mihaigabriel620/navhud-claude/docs/img/app-ui.png

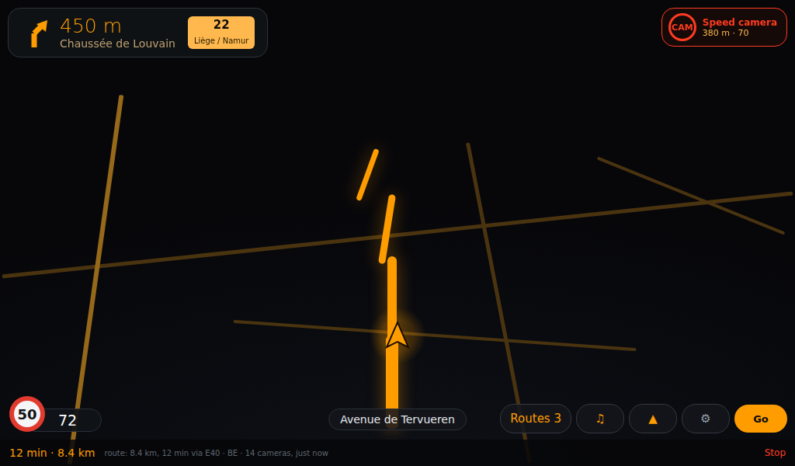
docs/img/app-ui.png
