mihaigabriel620/navhud-claude/docs/img/hud-themes.png

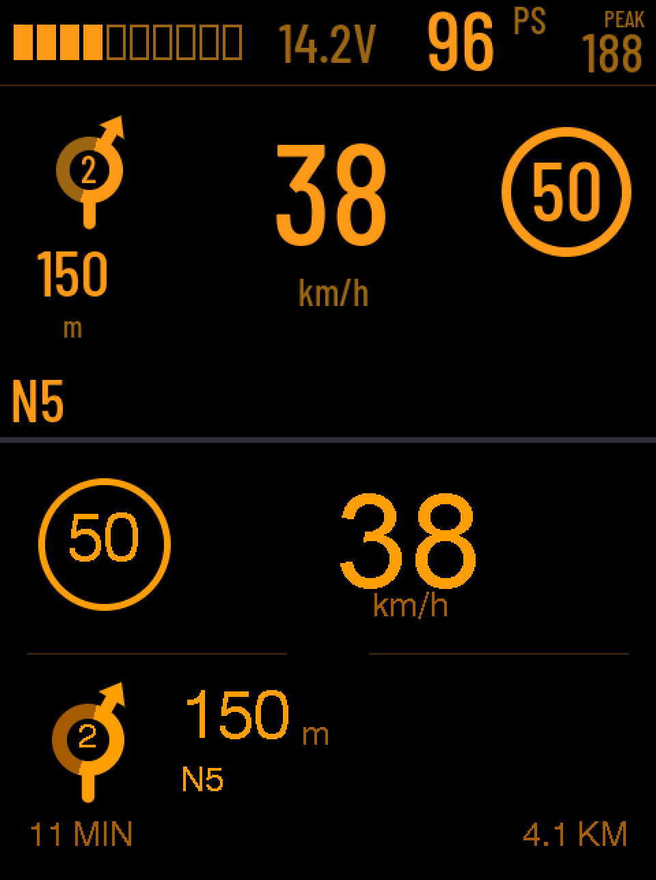
docs/img/hud-themes.png
