mihaigabriel620/navhud-claude/arduino/NavHud/hud_link.h

// ---------------------------------------------------------------------------
//  hud_link.h -- the cable to the phone.
//
//  Everything that crosses the USB serial line, in both directions: the frames
//  the board sends up (hello, compass, car) and the commands it takes back down
//  (geometry, alignment pattern, compass calibration).
//
//  If a message is missing, malformed, or the app and the board disagree about
//  what a field means, it is this file and PROTOCOL.md.
//
//  The wire format itself -- checksums, parsing, the frame grammar -- lives in
//  hud_protocol.h, which is shared with the host tests and knows nothing about
//  Serial.
// ---------------------------------------------------------------------------
#ifndef HUD_LINK_H
#define HUD_LINK_H

/**
 * Say out loud what the panel is doing, on the serial line.
 *
 * Plain text rather than $ sentences on purpose: a human with a serial monitor
 * is the audience, and the phone's parser ignores anything that does not start
 * with a '$' anyway.
 */
static void diag(const char* s) { Serial.print(s); Serial.print("\r\n"); }

static void sendLine(const char* body) {
  char line[80];
  snprintf(line, sizeof line, "$%s*%02X\r\n", body,
           HudParser::checksum(body, strlen(body)));
  Serial.print(line);
}

static void sendHello() {
  // Protocol 3. The board no longer advertises an IMU capability because there
  // is no longer any code that could use one; the app already treats $IMU as
  // optional and simply never sees one.
  sendLine("HELLO,NAVHUD,3");
}

#ifdef HUD_MAG
/**
 * $MAG,<headingDeg>,<calibrating>,<samples>,<fieldUt>,<spreadPct>,<mount>
 *
 * Magnetic north, not true: declination depends on where you are, the phone
 * knows that and this board does not. Absolute, and available standing still,
 * which is the one thing GPS cannot give.
 *
 * Sent only while the compass is genuinely reporting. A line that says 0.0
 * every 200 ms because the chip is absent is worse than silence -- the app
 * cannot tell it from actually pointing north.
 *
 * The field is six wide and stays six wide, because the app reads it
 * positionally. Field 5 was a rolling spread measure from the old driver; it is
 * now 0, because the QMC5883P renews its own offset on every measurement with
 * set-and-reset enabled and the number had stopped meaning anything.
 *
 * FIELD 6 IS LOAD-BEARING AND IT IS EASY TO GET WRONG. The app reads it as
 * "is the number in field 1 a heading for the CAR, or just for the chip", and
 * anything other than 1 makes it ignore the compass completely and fall back
 * to the phone's own sensors. That is the right rule and it is not changing.
 *
 * The rewrite briefly reported compass.calibrated() here, which meant a board
 * that had never been told `spin` sent 0 for ever and the app silently never
 * used the HUD compass at all. Wrong question: hard-iron calibration is about
 * how ACCURATE the heading is, not whether it is a car heading.
 *
 * The next attempt tied it to the measured field magnitude being plausible,
 * and that was wrong too -- wrong in a way worth writing down, because it
 * looked so reasonable. A scale-factor bug made the field read 13.3 uT instead
 * of 49, the plausibility check correctly said "that is not the Earth's field",
 * and field 6 went to 0 -- so the app threw away headings that were PERFECTLY
 * CORRECT. They were correct because the heading is atan2 of two components
 * scaled by the same factor, and atan2 does not care about scale. A magnitude
 * error cannot move the heading by one degree.
 *
 * So field 6 is now exactly what the app asks it: is this a car heading. The
 * chip is answering, so yes. Whether the magnitude looks like the Earth's is a
 * separate question with its own answer in field 4, which the app already
 * checks for its status line -- and which belongs in a warning, never in a
 * silent switch that disables the only absolute heading in the system.
 *
 * Alignment to the car is the `north` offset, which defaults to zero -- "the
 * chip points forwards" -- and one command fixes it.
 */
static void sendMag() {
  char body[72];
  snprintf(body, sizeof body, "MAG,%.1f,%u,%u,%.1f,%u,%u",
           compass.headingDeg,
           (unsigned)(compass.calibrating() ? 1 : 0),
           (unsigned)compass.calCount(),
           compass.fieldUt,
           0u,
           (unsigned)(compass.present() ? 1u : 0u));
  sendLine(body);
}
#endif
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
