mihaigabriel620/navhud-claude/(commit log)

2026-09-19 NavHUD 1.26 - recovered source, all fixes ported
    [AreaRoads.kt]
2026-09-23 Snap the marker to the road by default
    New pref key snap_to_road_v2 defaulting to true, so every install
    (including those that stored the old false default) switches to
    snapping. Getter/setter names unchanged.
2026-09-23 Draw the puck with a LocationIndicatorLayer
    The puck was a SymbolLayer over a GeoJSON source re-set every frame.
    GeoJSON updates are parsed on a worker thread and land a frame or more
    after the moveCamera beside them, so the arrow trailed the map. The
    indicator layer's position and bearing are layer properties, applied in
    the same render as the camera.
    LocationIndicatorLayer is package-private in MapLibre 11.8, so it is
    constructed by reflection (minify is off) and configured through the
    public Paint/LayoutPropertyValue constructors with the style-spec names.
    Location and bearing transitions are zeroed. The dot/arrow bitmaps are
    the bearing image, switched only when the heading becomes (un)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
2026-09-23 Fix map stutter: render at panel rate, no skipped frames, O(log n) pointAlong
    - setMaximumFps(30) made MapRenderer sleep to 33 ms per render while the
    camera moved every 16.7 ms vsync, so the map advanced 2-1-2 frames.
    It now uses the display refresh rate, capped at 60.
    - skipNextFrame removed: Choreographer never queues missed vsyncs, so the
    deliberate skip only doubled every hitch.
    - Geo.pointAlong (and so bearingAlong) binary-searches cum instead of
    scanning from vertex 0; GeoTest checks it against the old scan.
    [Geo.kt, GeoTest.kt]
2026-09-23 Voice: chimes as TTS earcons instead of a ToneGenerator on STREAM_MUSIC
    The ToneGenerator took no audio focus and played on the media stream, so a
    head unit treated each beep as a new media source and paused the music.
    Two short two-note chimes (warn falling, camera rising; 16-bit mono 22050 Hz,
    -6 dBFS, 10 ms fades) are now res/raw earcons registered after TTS init and
    played with playEarcon(QUEUE_ADD), under the same navigation-guidance audio
    attributes and utterance accounting as speech.
    [VoiceGuide.kt]
2026-09-23 Voice: one audio-focus hold per burst, released 300 ms after the last line
    Focus used to be abandoned the instant the utterance counter hit zero, i.e.
    between a chime and its line, and the request result was ignored. Now the
    release is posted to the main looper 300 ms after the queue empties and
    cancelled by the next line; request/abandon/release are serialised under one
    lock (tick thread, main thread and TTS binder thread all touch it). Focus is
    only marked held when AUDIOFOCUS_REQUEST_GRANTED; stopNow() and shutdown()
    release immediately. Legacy (API 24-25) path kept.
2026-09-23 Arrival ends the route
    RouteTracker also arrives when parked within 30 m of the pin with under
    60 m of route left. HudService ends navigation on the arrival frame via
    clearRoute() after the frame has gone to the HUD and the voice, so the
    tracker, route and destination go and reroute cannot send the driver
    back to where they are standing.
2026-09-23 Faster reroute: 30 m off-route, sustained heading shortcut
    OFF_ROUTE_M 45 -> 30. The heading shortcut is now: more than 45 degrees
    from the route bearing and more than 15 m off the line, held for 2 s,
    so it fires before the car is off the line at all. It replaces the
    zero-debounce 60 degree path, which at the new 30 m threshold would let
    a single multipath fix reroute. Only a fix under 2 s old counts as
    evidence, since the tick extrapolates older fixes along their bearing.
    Cooldown, confirm and obvious-distance rules unchanged.
    [HudService.kt, RouteTracker.kt, StutterAndReactionTest.kt]
2026-09-23 Voice: own queue, one item at a time, nothing interrupts anything
    Every urgent line used QUEUE_FLUSH, so turn calls, camera warnings and the
    speed warning cut each other off mid-word. VoiceQueue (voice/, pure, with a
    Speaker seam) now hands the engine one item -- chime + line -- at a time with
    QUEUE_ADD and starts the next on onDone/onError/onStop. Items carry a
    priority (HIGH: turn now, arrival, speed, camera; NORMAL: prepare; LOW:
    road features, closures, recalcul) and an expiry; LOW is dropped when
    anything is playing or waiting; a newer call for the same maneuver replaces
    a waiting one; a line whose end never arrives is written off after 20 s.
    QUEUE_FLUSH is left only to sample() and sto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
    [VoiceGuide.kt]
2026-09-24 Move the marker with a bounded rubber band instead of exponential easing
    New map/PuckMotion.kt (pure, unit-tested in PuckMotionTest):
    - PuckMotion: 1-D along-line motion. Target = fix along + v * fix age;
    drawn speed = v + bounded correction, changing at most 4 m/s^2; never
    moves backwards (slows to wait); jumps only past 300 m. Fix lost: runs
    on the reference speed (car speed, else last GPS speed) up to the coast
    limit, then holds. Fix back: converges without a snap.
    - FreeDriveMotion: the same band along the direction of travel (the
    matched road's bearing when known, so coasting follows a bend), with a
    bounded sideways correction and snapWithin applied last.
    MapActivity: the o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
2026-09-24 Voice: fold close turns into one call; onReroute() that does not repeat
    onFrame gains optional thenManeuver/thenGapM. When the "now" call is spoken
    and the next maneuver follows within max(150 m, 8 s at current speed), it
    becomes "Tournez à droite, puis tournez à gauche." (Phrases.immediateThen /
    brief, EN + FR) and the folded maneuver's prepare stage is marked spoken;
    its own "now" call still comes. Straight-on is never folded.
    onReroute() (thread-safe flag, applied on the next frame) clears the old
    route's keys but carries the last turn's stage across when the new route's
    first maneuver has the same instruction and is no further away than when it
    was announced; a turn already inside its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
2026-09-24 Heading: GPS course only while moving, rate-limited turns
    - HeadingFusion.moving: over 5 km/h, back under 3.5 km/h (the compass
    crossover constants), from the car's speed when the bus reports one
    (MapActivity now passes it to onFix too). While moving, onGyro,
    onOrientation and onExternalYawRate no longer change the heading, so
    it is the smoothed GPS course. Standstill/crawl behaviour unchanged.
    - Arrow and map share one heading while moving (Marker.headingFor gets
    a moving flag): the road bearing when snapped, else the GPS course.
    - NavCamera.turnToward: exponential easing capped at MAX_TURN_DPS
    (180 deg/s), used by the map bearing and the arrow. Replaces the
    instant >90 deg ju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
    [CameraAndMapTest.kt, HeadingFusion.kt, StutterAndReactionTest.kt]
2026-09-24 Speeding: SpeedingRule -- sustained, banded, once per excess
    The over-limit chime fired at limit+5 the instant the GPS speed crossed it,
    re-armed the instant it dipped back, repeated every 9 s up to 4 times, and
    treated an unknown limit as a re-arm. SpeedingRule (pure) now warns when the
    speed stays above limit + margin (10 up to 50, 20 up to 90, 30 above) for
    3 s, then holds a 3 min cooldown, re-armed early by 5 s at or below limit-10
    or by a change of the known limit. An unknown limit (0/-1) or no fix neither
    triggers nor re-arms and clears the sustain timer. VoiceGuide queues one
    HIGH item per trigger: warn earcon + "Vitesse limitée à X"; no bare beeps.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
    [VoiceGuide.kt]
2026-09-24 Waze-style vanishing route line, cut exactly under the arrow
    The route used to be one thinned source with a grey travelled overlay
    redrawn from the 4 Hz alongM on the 200 ms tick, so on bends the arrow
    (projected on the full geometry) sat off the drawn line and the cut
    lagged the car.
    New map/RouteLine.kt (pure, RouteLineTest): trafficLevels (the existing
    run-absorption logic, moved) and routeSlice(route, fromM, toM, levels,
    stride), which returns level runs starting at an interpolated point and
    sharing boundary vertices.
    MapActivity draws two sources: NEAR = arrow along -> far start at full
    resolution, rebuilt from the frame loop at most ~15 Hz from puckAlong
    (HudService.alongM when not s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
2026-09-24 Follow mode: only a one-finger pan unfollows; pinch and tilt are kept
    - Removed the touch listener and the REASON_API_GESTURE listener that
    dropped follow mode on any touch, pinch or tilt.
    - OnMoveListener: onMoveBegin with one pointer -> following = false.
    - OnShoveListener / OnScaleListener: while active the frame loop skips
    moveCamera; on end the tilt (clamped TILT_MIN..TILT_MAX) and a zoom
    offset on the speed-based zoom are stored in NavCamera and kept while
    following. NavCamera.reset (recenter / refollow) clears them.
    - Rotate gestures are disabled while following.
    [CameraAndMapTest.kt]
2026-09-24 Cameras: per-country rules for a drive across Europe, sourced
    CountryRules now covers the countries on a Belgium-Romania drive and its
    neighbours, each with its source (ADAC per-country table, Moniteur
    Automobile 2026, TomTom's legal page, VIAS 2023-R-16):
    EXACT BE NL LU AT HU RO HR IT ES PL; ZONE FR; OFF DE CH LI CY MK TR.
    Czechia, Slovakia, Slovenia (conflicting/unclear sources) and anything
    unchecked keep the cautious ZONE default.
    normalise() reads what lookups actually return -- ISO-2 in any case, OSM
    region codes (BE-VLG, DE:urban; Area.regionCode works offline), alpha-3,
    and country names in EN/FR/native -- so Mapbox's name fallback
    ("Allemagne") no longer drops Germany to danger-zon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
    [CameraAndMapTest.kt]
2026-09-24 Cameras: ANPR, 35 m corridor, rebase on reroute, offline cache
    - ANPR: the route query also asks for man_made=surveillance +
    surveillance:type=ALPR (OSM wiki; ANPR accepted, case-insensitive).
    New SpeedCamera.Kind.ANPR (appended, ordinals unchanged) for a plain
    plate camera; one that enforces a speed stays FIXED and a section-control
    device stays AVERAGE. Phrases.anprAhead: "Caméra ANPR dans ..." /
    "Number-plate camera in ...".
    - Corridor 15 m -> 35 m: route polylines sit 5-12 m off the carriageway and
    15 m dropped cameras on our own road; the parallel street is rejected by
    onOurRoad (CameraRoadTest's tolerance test updated to the new rule).
    - CameraWatcher.rebase(route) re-pi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
    [SpeedCameras.kt, VoiceGuide.kt]
2026-09-24 Keep the next 80 km of the route downloaded, in rolling chunks
    Offline tiles for the route ahead, without caching a 2000 km trip whole:
    - map/OfflineCorridor.kt (pure, OfflineCorridorTest): a chunk is the
    next 80 km of route from 1 km behind the car; a new one is due once
    the car is halfway through the current one (about 50 chunks for
    Belgium -> Romania). Its geometry is the route slice plus a line 1 km
    either side, thinned to <= 2000 points in total.
    - map/OfflineRoutes.kt: one MapLibre OfflineGeometryRegionDefinition
    per chunk (MultiLineString, z10-14, no ideographs), download set
    active and stopped when complete. Before each create it lists regions
    and deletes all of ours (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
2026-09-24 Waze-like reroute: forward bearings, loop-back penalty
    Directions requests send bearings=<h>,45 whenever the car is moving
    (car speed when fresh, else GPS > 2 m/s); alternatives stay on. The
    service keeps a 300 m GPS breadcrumb and the last on-route snapped
    position; on a reroute RouteChoice adds 180 s to any candidate that,
    within its first 3 km, comes back past the departure point or runs
    back along the breadcrumb for more than 100 m, so the fastest forward
    route wins. The existing U-turn tolerance rule is unchanged.
    [HudService.kt, MapboxProvider.kt]
2026-09-24 Speed limits on routes, and Europe-wide legal defaults
    RouteTracker takes an injectable limitFallback used where the router's
    maxspeed is unknown; HudService wires it to SpeedDefaults.limitAt (OSM
    window match, then legal default), the same derivation FreeTracker now
    reaches through SpeedDefaults.limitOf. The 400 m hold no longer carries
    a limit past a maneuver.
    SpeedDefaults gets one per-country table (BE-VLG/WAL/BRU, BE, NL, LU,
    FR, DE, AT, CH, CZ, SK, HU, RO, PL, IT, ES; checked against the OSM
    wiki legal-default table and implicit-value list and the cited national
    codes): urban, rural, expressway/trunk, 2x2 dual, motorway, urban
    motorway, living street. Bare BE urban is 50. AreaRoads' i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
    [AreaRoads.kt, DerivedLimitTest.kt, HudService.kt, RouteTracker.kt, SpeedDefaults.kt, SpeedDefaultsTest.kt]
2026-09-24 One speed for app and HUD
    HudService.displaySpeedMps is the raw (unscaled) bus speed when fresh
    and plausible, else GPS; it feeds HudFrame.speedKph on routes and in
    free drive, so the app gauge, the voice over-limit chime and the HUD
    agree. The scaled bestSpeedMps still places the car. CarLink latches a
    bus zero as implausible after 3 s with GPS above 15 km/h, until the
    bus reports motion again (the firmware sends 0 for a stale frame).
    carSpeedMps and carStopped are refreshed every tick, so they go null
    within a tick of the data going stale.
2026-09-24 Tunnel coasting in the service; thenManeuver accessor
    RouteTracker.coast() runs the position on along the route when the fix
    is gone (after the service's 8 s lead), at bestSpeedMps: the countdown,
    limits, maneuvers and snap carry on, the frame drops GPS_OK so the HUD
    says NO GPS. After RouteTracker.COAST_MAX_MS (180 s), or if the car was
    not on the route, it is exactly the old no-fix frame.
    HudService.alongM/alongAtMs are now the along-route distance of the
    last real fix (RouteTracker.alongOf, non-mutating) and that fix's
    elapsedRealtime, published once per fix and never advanced by the lead
    or by coasting. snapTrusted stays true while coasting.
    RouteTracker.thenManeuver: the maneuver afte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
    [HudService.kt, NavLogicTest.kt, RouteTracker.kt, SnapTest.kt]
2026-09-24 Rolling offline road cache along the route; fair use; cache labelling
    On a route the Overpass window follows the route: 2 km circles centred
    on the line every 2 km (AreaRoads.routeWindow). HudService prefetches
    them in rolling chunks -- ~100 km ahead, topped up when under 50 km is
    left, one request at a time on aux at least 3 s apart, skipping windows
    already fresh, restarting on a new route or reroute, backing off 30 s
    to 10 min on failure -- and the live lookup asks for the same window,
    so it is a disk hit and works with no signal. AreaCache also caps the
    total size (120 MB) so a long trip keeps only what is ahead.
    AreaCache names files by the exact circle they cover and returns it:
    a loo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
    [AreaRoads.kt, HudService.kt]
2026-09-24 Network failures stay quiet; route country from Mapbox admins
    Every Mapbox failure (no network, timeout, error page, non-JSON body,
    no route) now comes out as NavException, through an injectable GET used
    by the new failure-path tests. While a failed route request is retrying
    on its back-off (RerouteRule.retryDelayMs: 2, 4, 8, 16, then 20 s, for
    ever), maybeReroute starts no new requests, so a dead network is not
    hammered every 6 s cooldown and recalculating is not repeated; the
    old route keeps guiding meanwhile. setStatus cannot throw into a
    network thread's catch block.
    countryAt returns the ISO code or null, never the country's name.
    parseRoute reads each leg's admins and every intersecti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
    [HudService.kt, MapboxProvider.kt]
2026-09-24 Wire voice and camera work into the service; keep camera cache out of area lookups
    - voice.onFrame gets the maneuver after the next one ("... puis a gauche")
    - a replacing route calls voice.onReroute(), a fresh one voice.reset()
    - cameras are re-projected onto a new route at once (watcher.rebase), and
    successor() keeps the announced set across refreshes and country changes
    - cameraGen guards the camera fetch against reroutes, which keep routeGen
    - camera lists are cached on disk (SpeedCameras.fetch(r, AreaCache))
    - country: normalised lookup, OSM region code as the offline fallback, and
    the route's own per-segment country wins while a route runs
    - AreaCache.putNamed/getNamed: the camera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
    [HudService.kt, SpeedCameras.kt]
2026-09-24 Tunnels: ignore network fixes while the route is snapped on GPS
    Past FixFilter's 10 s grace a cell fix got through, refreshed the fix age,
    ended coasting and put the car up to 200 m off the line, so it rerouted
    from the surface. Ignored while the snap is trusted; used again once
    coasting gives up.
    [HudService.kt]
2026-09-24 Tunnels: a minute on a held GPS speed; a coast never arrives or says now
    Without the car bus the service and the map coast at the last GPS speed,
    held constant, for 60 s (180 s at bus speed, as before). A coasted frame
    no longer carries the arrival flag, so a tunnel or car park cannot end the
    route, and without the bus it cannot fire a turn's final "now" call; that
    waits for the first real fix. The map takes its coast speed from the
    service's fix, which in a tunnel is still the last GPS one.
    [HudService.kt, RouteTracker.kt, SnapTest.kt, VoiceGuide.kt]
2026-09-24 Reroute: adopt on the tick thread, with the new route's alongM first
    adoptRoute ran on the network thread, so a tick still on the old route
    could overwrite the new route's alongM and spend the voice's reroute
    memory on an old frame. It is now posted to the worker, as a picked
    alternative already was, and releases `rerouting` there. It publishes
    the new route's distance for the last fix before the route itself and
    clears snapTrusted until the new tracker's first tick, so the map no
    longer places the arrow at the old route's metres on the new line.
    [HudService.kt, SnapTest.kt]
2026-09-24 Cameras: lock the announced set that successor() copies across threads
    The tick adds to it while successor() iterates it from the camera fetch,
    the country lookup or the settings screen; a ConcurrentModificationException
    on the aux executor is uncaught and kills the app.
2026-09-24 Area cache: write files whole; drop and refetch one that is unreadable
    A power cut mid-write left half a JSON body under the real name, and the
    fresh-hit path parsed it before ever trying the network, so that window
    failed for a week. Files are now written aside and renamed into place,
    and a cached window that will not parse is deleted and fetched again.
    [AreaRoads.kt]
2026-09-24 Map: judge "stopped" on the car's speed, as "moving" already is
    Parked with the bus reading zero, GPS wander of 1-2 m/s made the map
    think the car was rolling, so a snapped road bearing overrode the
    heading the car was actually facing.
2026-09-24 Icons from the supplied pack: road-ahead chip signs, ANPR map pin
    The road-ahead chip now carries the sign for a level crossing (pack
    rm_railroad, its pale ground shadow darkened for the dark map) or a
    speed bump (pack permanent_hazard_speed_bumps, recoloured from yellow
    to the app amber with dark-on-amber ink). Toll booths and closures keep
    text only: the pack has no matching sign.
    ANPR cameras get their own map pin: the camera bitmap in amber, raised
    over a number plate, chosen per feature by a "kind" property.
2026-09-24 Camera panel: label ANPR cameras as such
2026-09-24 CI: setup-java v5 (v4 deprecated), pin ubuntu-24.04 before the 26.04 switch
2026-09-24 Voice: 3 calls for motorway exits, camera calls quote the stage distance, music focus fixes
    - Exits, slip roads and forks get 1200/500/200 m calls at >=90 km/h (scaled
    down with speed); ordinary turns keep their 2 calls.
    - Speed cameras: 1000/500/200 m at >=90 km/h, 600/300/150 at >=50. The voice
    quotes the stage's round distance, never the live one (the 'in 13 m' call),
    and says just 'Radar' under 50 m. The HUD still shows the live distance.
    - TTS is marked ready only after its navigation audio attributes are set, so
    no line can go out as plain media (which stops music on a head unit).
    - Audio focus watchdog: a line whose end never comes back no longer keeps
    the music ducked/pause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
    [CameraAndMapTest.kt, SpeedCameras.kt, VoiceGuide.kt, VoiceGuideTest.kt]
2026-09-24 Arrow: on the route line up to 50 m, else on the nearest OSM road, raw fix last
    With a route, the arrow fell back to the raw GPS fix (beside the road) as soon
    as the route snap lost trust at 25 m cross-track, or while off route before
    the reroute arrived. Now the map draws it on the route line while within 50 m
    and not off route; otherwise on the nearest OSM road (AreaRoads.match, 35 m);
    the raw fix only when no road is near (car park, driveway).
    Settings > diagnostics: 'Show arrow debug line' puts ROUTE/ROAD/RAW,
    cross-track, trust and GPS accuracy on the map for the next test drive.
    Claude-Session: https://claude.ai/code/session_01P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
    [HudService.kt, MainActivity.kt, RouteTracker.kt, SnapTest.kt]
2026-09-24 Setup: show offline cache status (roads/cameras on disk, map tile chunk ahead)
    Claude-Session: https://claude.ai/code/session_01PBqYeSK4cVS6JAR2wXgoxy
2026-09-24 Cameras: next camera ahead takes over at once; merge duplicates within 50 m
    The last warning at 13 m was late, not only worded wrong: the watcher kept
    the alert on a camera until 40 m past it, so a camera just after it (often
    the same device mapped twice in OSM) got its last call almost on top of it.
    - CameraWatcher picks the first camera ahead; the one just passed is only a
    display fallback and is never announced.
    - Same-kind cameras facing the same way within 50 m (along the route, or
    straight-line in free drive) are merged; limit/kind kept from either.
    - Debug line on the map shows the camera alert.
    Tests: two cameras 30 m apart warn once (1000/500/200), non-duplicates kept,
    next came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
    [AreaRoads.kt, CameraAndMapTest.kt, SpeedCameras.kt]
2026-09-24 App 1.29: arrow locked to its road, "Waiting for GPS", pill flush left
    - map/RoadLock: the map picks the nearest road within 150 m and keeps it;
    fixes move the arrow only along it, standing still holds it, road changes
    only while driving (clearly nearer road on 2 fixes, off the end of the way
    at a junction, or >100 m away). Used in free drive and off the route line.
    1.28 relied on the service's per-fix 35 m match and fell back to the raw fix.
    - No arrow before the first fresh GPS fix or after GPS loss once coasting
    ends; a centred "Waiting for GPS" instead. Cell fixes neither draw nor lock.
    - Arrow debug line: LOCK <road> [held] / RAW <why> / WAIT, provider.
    - Trip pill flush again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
    [AreaRoads.kt, HudService.kt]
2026-09-24 App 1.29.1: search box back in place; only the search button moves into its rounded end
2026-09-24 Location: ask FINE+COARSE together; say "Precise location needed" on approximate
    Android 12+ may ignore FINE requested alone, and the driver can pick
    "Approximate". Navigation still requires FINE, but the map screen now shows
    a notice with a tap-through to the app settings instead of doing nothing,
    and Setup lists Location with an "Open app settings" button. Notice gained
    an optional action line.
2026-09-24 Start with the car: ask for "Allow all the time"; don't start blind at boot
    ACCESS_BACKGROUND_LOCATION was declared but never requested, so on
    Android 11+ the boot-started service got no location (14+: it could not
    go foreground and stopped). Setup now explains and asks for it on its own
    (API 29+) when start-on-boot is on; BootReceiver stays down on 11+ without
    it, and Setup shows a "Start with the car" line with the settings button.
2026-09-24 HUD: blank camera bar and lane strip when a new destination replaces the route
    The new-destination branch nulled cameraAlert and lanes without sending the
    clearing frames clearRoute sends, so the HUD kept the old camera warning and
    lane arrows. A flag now makes the tick send CAM,0,0,0 and LANE,0,0 once the
    link is open, and resets lastLanesSent there.
    [HudService.kt]
2026-09-24 CLAUDE.md: owner currently prefers PC sessions
2026-09-24 USB: stop re-asking after a refusal; make "open when granted" work
    Any answer to the USB permission dialog reset the ask throttle, so a
    refusal brought the dialog back every ~3 s over the map. Now only a grant
    (checked with hasPermission; the immutable PendingIntent carries no extra)
    opens at once; a refusal is remembered for that device id until it is
    replugged or a new link is built. The opener executor was shut by every
    open (closeLocked), so the grant path never ran: it is now retired only by
    the public close(), and a write failure closes internally.
2026-09-24 Location switch off: say "Turn on Location" instead of blaming the permission
    On Android 14+ a location foreground service also needs the Location
    switch on; the service stopped with "location permission is required".
    It now says "turn on Location" when that is the cause, and the map screen
    shows a notice with a tap-through to the location settings.
2026-09-24 Setup: warn when notifications are off, with a button to allow them
    On Android 13+ a refused notification permission hides the service's
    notification, and with it the only Stop action and the "Resume route?"
    offer. Setup now lists Notifications and offers the app's notification
    settings.
2026-09-24 Map: a recreation after Stop no longer restarts the service
    firstResume was per instance, so the dusk night-mode recreation counted as
    opening the app and switched the stopped service back on. It is now true
    only when there is no saved state.
2026-09-24 Setup: Bluetooth switch and Mapbox token apply to the running service
    Both only wrote prefs, so they took effect on the next start. The token now
    goes through HudService.applyPrefs (which rebuilds the router), and the
    Bluetooth switch sends ACTION_START with the new setting when the service
    is running.
2026-09-24 Setup: list the offline-roads cache off the main thread, every 5 s
    AreaCache.fileCount()/sizeBytes() list a directory of many files and ran
    on the main thread with every 400 ms poll. They now run on a worker thread
    at most every 5 s; the poll shows the last result.
2026-09-24 Voice: rebuild the guide on the next start when TTS failed to initialise
    A TTS init failure was only logged and the voice stayed silent for the
    whole session. VoiceGuide now records initFailed (distinct from "still
    starting"), and HudService.onStartCommand replaces such a guide.
    [HudService.kt, VoiceGuide.kt]
2026-09-25 Cameras: a danger zone is announced once and outlasts the camera
    In ZONE mode the stage still came from the real distance, so "zone de
    danger" was spoken again at 500/200 m (or 300/150 m) before the camera,
    and the alert ended at the camera (route: 40 m after; free drive: at it).
    Both mark the camera's position, which art. R413-15 forbids. Zone mode
    now uses stage 0 only, and the passed camera holds the zone for half the
    zone length (zoneTailM), silently.
2026-09-25 Speed: show the car's own speed when there is no live GPS fix
    Free drive without a fix, a route before its first fix and a tunnel past
    the coast limit all built a frame with speedKph = -1, so the gauge showed
    "--" while the bus speed was fresh. Owner rule: the car's speed whenever
    CAN speed is valid, else GPS. The no-fix frames now take the raw bus
    speed (busKph), -1 only when the bus has none.
    [HudService.kt, RegressionCheckTest.kt, RouteTracker.kt]
2026-09-25 Cameras: no route-camera alerts while off the route
    Off route (and while an offline reroute keeps retrying) the watcher was
    still fed t.alongM, our projection onto the road we left, so the old
    route's cameras could be announced. pushCameras now clears the alert
    while the tracker says off-route, as it does with no watcher.
2026-09-25 Map: without the car's speed, a held arrow stays held until the fix moves
    With no CAN speed RoadLock held the arrow only while the GPS speed was
    under 0.7 m/s, but a parked receiver reports 1-2 m/s of multipath
    wander, so indoors the arrow still crept along the road. On GPS speed
    alone a hold now ends only once the projected fix is more than
    max(accuracy, 10 m) from the held point; with the bus the speed rule
    stays.
    [RegressionCheckTest.kt]
2026-09-25 Voice: forks and slip roads in town get two calls, not three
    Below 50 km/h forks, ramps and keep-left/right used SLOW_EXIT
    (300/120/50 m), three calls on turns that come close together; the owner
    said the app talks too much there. They now use the normal town band;
    the 50-89 km/h and motorway (1200/500/200 m) exit bands are unchanged.
    SLOW_EXIT is gone with its only use.
    [RegressionCheckTest.kt, VoiceGuide.kt, VoiceGuideTest.kt]
2026-09-25 Reroute: no loop while parked off the road before joining the route
    A route starts on the street, so a car in a car park 80 m away (or
    parked 30+ m off the road when a reroute was made) was off route at
    once and rerouted every ~6 s while standing. RouteTracker now keeps the
    first cross-track distance and a `joined` flag (first time within
    30 m); until joined only moving 30 m further away counts as off the
    line, and the heading shortcut in maybeReroute waits for joined too.
    [HudService.kt, RegressionCheckTest.kt, RouteTracker.kt, StutterAndReactionTest.kt]
2026-09-25 Roundabout: take the exit angle from the banner's degrees
    The arrow came from bearing_after - bearing_before of the roundabout
    step, which Mapbox/OSRM put at the roundabout ENTRY, so it showed the
    veer into the circle rather than the exit. The banner primary's
    `degrees` ("the degrees at which you will be exiting a roundabout,
    assuming 180 indicates going straight through") is now preferred:
    turn = 180 - degrees, mirrored for driving_side=left (banner, else
    step). The bearings remain the fallback; exit pairing ($RAB) is
    unchanged. Needs confirming on the road.
2026-09-25 HUD: a reroute clears the old route's lane arrows on the board
    adoptRoute forgot lastLanesSent without sending LANE,0,0, so pushLanes
    then saw "none wanted, none sent" and sent nothing: the missed exit's
    lanes stayed on the HUD. The clear is now sent first (adoptRoute runs
    on the tick thread).
    [HudService.kt]
2026-09-25 Cameras: refetch as soon as alerts are allowed again after an OFF country
    A reroute where camera alerts are OFF (Germany) emptied the camera list
    but left lastCameraFetchMs at the last real fetch, so after the border
    maybeRefreshCameras waited up to 30 min: no Belgian/Austrian cameras
    for tens of km. The OFF branch now resets it to 0.
    [HudService.kt]
2026-09-25 Map: the road lock's first pick is bounded by the fix's accuracy
    RoadLock picked any road within 150 m, so an accurate GPS fix in a car
    park snapped the arrow to the street 80 m away while the service said
    "no road". With a known accuracy the pick radius is now
    min(150, max(35, 2 x accuracy)); an indoor +-60 m fix still locks.
    [RegressionCheckTest.kt]
2026-09-25 Country: a service start keeps the detected country
    Every ACTION_START (the map screen sends one whenever it comes to the
    front) reset the country to home without resetting the 25 km recheck,
    so free drive abroad kept Belgian camera rules - positions shown in
    Germany - for up to 25 km. Home is now only the default before a
    lookup has answered.
    [HudService.kt]
2026-09-25 Heading: restore the parked heading on the first GPS fix, not any fix
    The one restore attempt ran on the first accepted fix, which can be a
    network fix hundreds of metres wide: it missed the 15 m match and the
    parked heading was never restored. The attempt now waits for a GPS fix.
    [HudService.kt]
2026-09-25 Firmware tests: render every HUD screen to PNG (make render)
    tft_stub.h built with -DHUD_RENDER rasterises each call into a 480x320
    RGB565 framebuffer using TFT_eSPI 2.5.43's own algorithms (tft_raster.h):
    circles, triangles (int32 truncation), padding, smooth .vlw fonts and the
    library's built-in fonts, fetched pinned into .tft_espi. render_screens.cpp
    draws splashes, NO LINK, the alignment pattern, the shared layout corpus
    (now corpus.h) plus camera/roundabout/car-only extras for both themes into
    out/<theme>_<nn>_<name>.png, via a dependency-free PNG writer.
    Stub fixes found on the way: MR_DATUM text boxes were recorded as TL, and
    a 20-char corpus street was left without its NUL.
    Co-Auth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
    [corpus.h, png_write.h, render_screens.cpp, test_layout.cpp, tft_raster.h, tft_stub.h]
2026-09-25 Firmware tests: make check green again, and a firmware CI workflow
    The CAN and sketch suites had not compiled since the 2.x rewrite: they
    wanted Arduino.h, the hand-written MCP2515 driver, hud_mount.h and
    hud_imu.h, none of which exist any more.
    - test/Arduino.h and test/mcp_can.h: host stand-ins. mcp_can.h follows
    mcp_can 1.5.1's own receive path (READ STATUS, register reads, DLC & 0x0F,
    id flags in bits 31/30) and counts the DLC>8 overrun the real library has.
    - SPI.h: the MCP2515 simulator gains READ STATUS, register-window receive
    buffers (where mcp_can reads them), RXnOVR on a full buffer, 29-bit ids,
    RTR frames and a stuck-MISO mode.
    - test_can.cpp rewritten for canBegin()/can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
    [Arduino.h, SPI.h, Wire.h, mcp_can.h, test_can.cpp, test_sketch.cpp, tft_stub.h]
2026-09-25 Firmware: $RAB was parsed and then thrown away
    linkPump() had no branch for HUD_RAB, so the bearing only reached the
    parser's scratch copy, and the `tmp = cur` resync after every frame
    discarded it. Every roundabout was drawn from the exit-number table, as if
    the phone had never sent an angle. It is now copied into `cur` like $CAM
    and $LANE, and marks the screen for a repaint.
    Test (sketch_*, group 18b) fails without the fix: the angle stayed at
    HUD_RB_ANGLE_NONE.
    Claude-Session: https://claude.ai/code/session_01E3HoeeUR4dV9iZLd4Eqfe2
    [hud_link.h, test_sketch.cpp]
2026-09-25 Dash theme: the PS number no longer erases the battery's "V"
    The PS field's padding was 106 px, sized for "-888", so its background
    fill ran from x 257 while the battery reading "14.2V" ends at 276: every
    PS change (the 0x0A8 frame rate) wiped the "V". The padding now stops at
    the battery field's own box (DASH_VOLT_X + 74), which still covers every
    three-character value ("500" is 80 px, "-99" 70). Below -99 PS -- about
    three times this engine's overrun braking -- the field shows -99 instead
    of four characters over the battery.
    New pixel checks in the renderer (make render, run by CI): a field drawn
    alone must keep every lit pixel on the full screen. The battery check
    failed for every PS val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
    [render_screens.cpp, theme_dash.h]
2026-09-25 E60 theme: the km/h label no longer cuts off the bottom of the speed
    Font 4's 26 px cell for "km/h" (bottom-centre at y 130) starts at y 104,
    four rows above the bottom of the font 8 digits, and its background fill
    clipped them on every speed. The label is now drawn without a background:
    e60DrawSpeed clears the whole block first, so nothing needs painting over.
    The renderer's pixel check (speed digits must survive the label) failed
    for every speed before: 48-53 digit pixels erased.
    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
    [theme_e60.h]
2026-09-25 HUD roundabout redesign: smooth ring, driven path, every known exit
    What the owner picked from the Google Maps / Waze references, in the HUD's
    colours: a thick anti-aliased ring; the part you drive (in, round, out)
    bold, the rest dim; a stub for every exit the phone knows about; the exit
    number in the hole with no box; a big arrow on the real exit; mirrored for
    left-hand traffic. Both themes draw it (E60 in its own palette); the old
    table-only drawRoundaboutArt is gone.
    - New frame $RBX,<exit>,<side>[,<a1>..<aN>]: every exit's angle up to the
    one to take, and the side of the road. $RAB is still read, for older apps.
    - The ring's dotted look came from concentric 1-px drawCircle calls. It i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
    [hud_arrows.h, hud_canvas.h, hud_link.h, hud_protocol.h, hud_theme.h, render_screens.cpp, test_protocol.cpp, test_sketch.cpp]
2026-09-25 E60 theme: a clear gap between the speed and its km/h label
    Drawing the label without a background (previous commit) stopped it
    cutting the digits, but its ascenders then started on the row right under
    them (digits end at y 105, letters began at 106). The label moves down four
    rows (baseline 134); the speed block still clears to y 145.
    New renderer check: at least two clear rows between the lowest digit pixel
    and the label. It failed with 0 before this change.
    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
    [render_screens.cpp, theme_e60.h]
2026-09-25 HUD roundabout: no exit stubs, and no $RBX frame (owner's choice)
    The owner compared the renders and chose the cleaner picture: the ring
    dim, the path you drive bright from the entry round to the exit, and the
    arrow at the real angle -- no stubs for the other exits. Without the stubs
    nothing needs the exit list, so $RBX is gone again; $RAB carries the angle
    as before.
    Left-hand traffic still needs one fact -- which way the ring runs -- and
    it now rides on the $HUD frame as flags bit 7 (FLAG_LEFT_HAND). Firmware
    before 2.8 tests only the bits it knows, and an app that does not set it
    means right-hand traffic, so both mixes keep working.
    The render gallery now shows exits at 9, 10, 12, 1 and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
2026-09-25 App: roundabout exit angle from the intersections, left-hand traffic flag
    - The fallback exit angle was bearing_after - bearing_before. On a
    roundabout step the maneuver is the ENTRY, and bearing_after is "the
    direction of travel immediately after the maneuver" (OSRM/Mapbox docs):
    the veer onto the ring, whatever the exit. It now comes from the step's
    intersections, counted as Mapbox counts `exit` (a node with an entry=true
    road that is neither `in` nor `out`); at the exit's node `out` is the
    exit road. The banner's `degrees` still wins when it is there. U-turns
    are -180 (right-hand traffic) or +180 (left-hand), never a coin toss.
    - Left-hand traffic (step/banner driving_side "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
2026-09-25 Firmware: a CAN module dying mid-drain no longer hangs the board
    canPump()'s drain loop counted only frames it delivered. A refused length
    (DLC 9..15) did `continue` without counting, so if the MCP2515 lost power
    or a wire lifted during the loop -- every READ STATUS then says a frame is
    waiting and every length reads 15 -- it discarded for ever and the
    ESP8266's soft watchdog reset the board. The loop now counts buffers
    handled; the dead module is caught by the status check at the top of the
    next call, as before.
    Test: the MCP2515 simulator can now die at a chosen transaction (with a
    guard that ends a runaway loop instead of hanging the test). It ran away
    before this change and returns with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
    [SPI.h, hud_can.h, test_can.cpp]
2026-09-25 Firmware: no CAN speed spike after a long repaint
    After a gap between drains longer than CAN_STALE_GAP_MS the speed baseline
    was dropped -- and then rebuilt from the frames the MCP2515 had held
    through the gap. Those are the OLDEST frames of it (a full buffer drops
    the newer ones), stamped when finally read, so the next fresh frame read
    the whole repaint's distance over one frame's time. At a steady 50 km/h
    the test showed 200 km/h, well inside the 300 km/h sanity limit, on the
    glass and on $CAR. Speed frames read in the drain after a gap are now
    skipped; the next two fresh ones re-acquire.
    Test: steady 50 km/h, 150 ms without a drain, then normal frames. Worst
    error 150 km/h before, 0 afte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
    [hud_can.h, test_can.cpp]
2026-09-25 test_can: the repaint test's clock ran backwards
    The previous commit's new check failed and went in anyway: after each
    inner loop the next outer pass drained at an EARLIER time than the last
    drain, so every pass looked like a long gap and re-baselined -- the speed
    was never measured again, in the test only. The timeline is now one 10 ms
    clock (a frame every 100 ms, a drain every 30 ms).
    Re-verified: worst error 116.7 km/h with the drain fix taken out, 5.6 km/h
    (ordinary drain-time jitter) with it, and the speed is measured again.
    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
    [test_can.cpp]
2026-09-25 Firmware: $CAR sends -1 when the bus's speed has gone stale
    sendCar() sent car.kmh whatever its age, and car.kmh is never cleared: if
    0x1A6 stopped while the MCP2515 stayed up, the board repeated the last
    speed for ever. The app prefers the car's speed to GPS whenever a $CAR line
    is fresh, so both displays froze on it. The first field is now -1 once
    0x1A6 is older than CAR_STALE_MS; CarLink already refuses a negative speed
    (unchanged app code), so the last good line ages out in 2 s and GPS takes
    over.
    Tests: sketch group 18c (sent 87 before, -1 now); CarLinkTest pins the
    app side of the contract.
    Claude-Session: https://claude.ai/code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
2026-09-25 Dash theme: a stale battery reading now leaves the glass
    dashVolts_() blanked the field by drawing a padded space in BG-on-BG, and
    TFT_eSPI fills the padding only when the text and background colours
    differ (TFT_eSPI.cpp:5666), so nothing was cleared: "14.2V" stayed lit
    through every crank and for ever after 0x3B4 stopped. The blank now uses
    the dim colour on the background; a space has no lit pixels, so only the
    padding fill shows.
    Renderer pixel check: 739 px left lit before, none after.
    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
2026-09-25 Firmware: dragging a keystone slider could dismiss the alignment grid
    stageGeom() stamped geomLastMsgMs with a fresh millis(), while loop()
    compares it against the `now` it read at the start of the pass. When the
    clock ticked in between, `now - geomLastMsgMs` underflowed to about four
    billion and the idle check dismissed the grid in the same pass -- the
    likelier the more $GEOM frames a drag sent -- and the app only re-sends
    $GEOMTEST,1 when the Keystone screen resumes. It is stamped with `now`, as
    every other message already was.
    Test (sketch group 12): a $GEOM read a tick after the pass began. The
    grid was gone before; it stays now.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
2026-09-25 Firmware: the alignment grid waits two minutes again, as documented
    GEOM_TEST_IDLE_MS was 15 s, while PROTOCOL.md, the Keystone screen and the
    1.22 notes all say two minutes. The Keystone screen sends nothing while no
    slider moves, so fifteen seconds of looking at the windscreen removed the
    grid until the screen was left and reopened. Back to 120 s; a crashed app
    still cannot leave the grid up for longer than that.
    Test (sketch group 12): a minute without a $GEOM keeps the grid up; it
    failed at 15 s.
    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
    [hud_config.h, test_sketch.cpp]
2026-09-25 Firmware: a returning link no longer repaints the last trip's limit
    displayForgetPhone() cleared only the camera and lane fields of `cur`. The
    link counts as back on ANY message -- a heartbeat, the Keystone screen's
    $GEOM? -- and that repaints the drive layout from `cur` at once, before a
    $HUD frame has said anything: the speed limit, turn and street from before
    the drop went back on the glass. It now forgets all of `cur` (the stale
    roundabout angle included); the phone resends everything on its next tick.
    Test (sketch group 5b): link dropped with a limit and a turn, back with a
    PING. The old limit and turn came back before; nothing does now.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
    [hud_display.h, test_sketch.cpp]
2026-09-25 App: lane arrows come back after the HUD link drops
    The board forgets the lanes whenever it hears nothing for two seconds (a
    cable glitch, a restart), and pushLanes() only sent them when they changed
    -- so with the same lanes still applying they never went out again, and the
    E60 lane strip stayed empty up to the junction. Lanes that apply now go out
    every tick, as $CAM does; the clearing line still goes once. The board
    redraws only what differs, so a repeat costs nothing on the glass.
    LaneGuidance.lineFor() holds the rule so it can be tested
    (LaneGuidanceTest, 28/28 on the JVM).
    Claude-Session: https://claude.ai/code/session_01E3HoeeU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
    [HudService.kt, LaneGuidanceTest.kt]
2026-09-25 Firmware: the MCP2515 is kept in listen-only, and the tests prove it
    Checked against mcp_can 1.5.1: begin() resets the chip and leaves it in
    LOOPBACK (TXCAN held recessive), then canBegin() asks for LISTEN-ONLY, in
    which the chip cannot put a bit on the bus -- not a frame, not an
    acknowledge, not an error flag. There was never a window in normal mode,
    and the firmware has no transmit call anywhere.
    What could still leave listen-only: the chip shares its SPI bus with the
    display, so a chip-select glitch could clock display bytes in as a write to
    CANCTRL; and a module that browns out comes back in configuration mode
    with its bit timing and filters gone. canPump() now reads CANSTAT on every
    ca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
    [SPI.h, hud_can.h, hud_link.h, test_can.cpp, test_sketch.cpp]
2026-09-25 Firmware: no flash of full daylight when the key cycles at night
    Coming back from dark, backlightUpdate() chose daylight unless a $HUD
    frame arrived in that very pass. With the phone connected its last frame
    (under LINK_TIMEOUT_MS old) already said night, so a key cycled at night lit
    the panel at 255 until the next frame. It now uses that frame's night flag
    when the phone is up; with no phone it is still daylight.
    Test (sketch_e60, backlight group): key out and back in at night with the
    phone up. 255 before, BACKLIGHT_NIGHT now.
    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
2026-09-25 Dash theme: the camera warning no longer flickers as it counts down
    $CAM carries the live distance, four times a second, and dashStreet_()
    answered every change by clearing the whole bottom band and redrawing: the
    red line blanked at 4 Hz. While it stays a camera line it is now redrawn in
    place, padded to the band's edge -- a padded smooth font paints its own
    background -- and the band is only cleared when the line changes kind
    (street <-> camera). Street names are untouched.
    Tests: sketch_dash 5c (a distance update must not clear the band; it did),
    and a renderer check that 1350 m -> 25 m -> ZONE redrawn in place is
    pixel-identical to each drawn on a cleared band.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
    [render_screens.cpp, test_sketch.cpp, theme_dash.h]
2026-09-25 Firmware: one bad CAN read no longer writes the bus off for the drive
    canPump() treated a single READ STATUS of 0xFF as a dead module and set
    canOk false for good. With no controller the panel cannot know the key, so
    it is lit whatever the key says, and the car half of the display is gone
    until the next power cycle -- for one glitch, or a connector that let go
    for a moment.
    - The 0xFF is read twice before it is believed.
    - canRecover(): a controller that WAS working and stopped answering is
    looked for again every CAN_RETRY_MS (5 s) -- the pre-flight's 8 ms probe,
    and the full bring-up (ending in listen-only) only once the chip answers.
    Never for a board whose controller did not come u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
    [NavHud.ino, SPI.h, hud_can.h, hud_config.h, test_can.cpp]
2026-09-25 Firmware: a new compass calibration is no longer erased by an older forget
    `forget` and a calibration write both wait for a standstill, and the forget
    always ran first: `forget` while moving, then `spin stop` (accepted) or
    `north <deg>`, and the next stop erased the new calibration in RAM and
    flash after it had been reported as accepted. Queuing a save now cancels a
    forget still waiting (magQueueSave(), used by `spin stop`, `north` and
    $MAGCAL,0). A forget typed after a save still wins, as before.
    Test (sketch group 18d, all three builds): forget, then north 90, then a
    standstill. The offset was 0 before, 90 now.
    Claude-Session: https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
    [hud_link.h, test_sketch.cpp]
2026-09-25 Firmware: a compass that browns out mid-drive is found again
    After a brown-out the QMC5883P comes back in suspend mode: DRDY never sets,
    update() returned false for ever, and since the chip still counted as
    present the sketch's MAG_RETRY_MS retry never ran -- $MAG stopped for the
    rest of the drive and `status` still said the compass was there. At 100 Hz
    a second without a sample (COMPASS_SILENT_MS) means it is not measuring, so
    it stops being called present and the existing retry brings it back (the
    chip's DRDY with an overflow still counts as measuring).
    Tests: the host I2C stub now models suspend mode (DRDY only in continuous
    mode) and a brown-out; sketch group 18e -- re-found by the retr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
    [Wire.h, hud_compass.h, test_sketch.cpp]
2026-09-25 App: phone card and HUD agree on a roundabout with no exit number
    Mapbox's "roundabout turn" has no `exit`. $RAB cannot carry an angle
    without one, so the HUD draws a bare ring -- but the tracker still put the
    banner's angle on the frame, and the phone's card drew an arrow beside it.
    The frame now carries the angle only with an exit number 1..12, so both
    displays show the bare ring.
    Tests (RoundaboutBearingTest, 19/19 on the JVM): the tracker's frame
    carries exit, angle and the left-hand flag; with no exit number and a
    banner angle it carries none (it carried -90 before).
    Claude-Session: https://claude.ai/code/session_01E3HoeeUR4dV9iZ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
2026-09-25 Docs: 2.8 and app 1.32 notes, PROTOCOL.md brought up to date
    - CHANGELOG: `## App 1.32` and `## 2.8` in plain words (the version bump
    that publishes 1.32 waits for the owner's OK on the roundabout).
    - PROTOCOL.md: $RAB and $CAR documented (with the -1 for a stale speed),
    flags bit 7 (left-hand traffic), the typed commands as they really are
    (spin / spin stop / north / forget / wipe -- no `mount`, no `spin save`),
    $CAM and $LANE sent every tick while they apply, the 2 s link timeout,
    and the gyroscope sections marked as gone.
    - CLAUDE.md: the HUD firmware section for 2.8 -- sizes, the new CI
    workflow, all host suites green, the listen-only guarantee.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
2026-09-25 Test: RegressionCheckTest no longer pins the entry-veer roundabout angle
    be813c4 dropped bearing_after - bearing_before as the roundabout fallback
    (it is the veer into the circle, not the exit). The regression check still
    expected 60 from it; with no degrees and no intersections the angle is now
    null and both displays use the exit-number table.
    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
    [RegressionCheckTest.kt]
2026-09-25 Docs: README pictures redrawn from the 2.8 firmware
    The pictures showed the old 320x240 screen and the 2.7 roundabout. They are
    now the firmware's own framebuffer from `make render` (480x320, 2x):
    - hud-states.png: the default dash theme, four moments of a drive
    - hud-e60.png: the same four in the E60 theme
    - hud-themes.png: one moment in both themes
    - hud-roundabouts.png (new): the roundabout exits, as approved for 2.8
    `make docs-images` (arduino/test/docs_images.py, needs Pillow) rebuilds
    them. README: the diagram names the real board and screen (ESP8266,
    ST7796 480x320), the text matches the pictures, and "Install the app"
    points to the Releases page instead of the apk/ folder that no lon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
2026-09-25 Firmware 2.9: everything drawn smooth, no pinholes, no seams
    The owner saw black dots on every picture and asked for everything to be as
    polished as 480x320 allows.
    - Rings (speed limit, destination target) were stacked one-pixel circles,
    which leave pinholes at every diagonal; they are TFT_eSPI's smooth drawArc.
    - New hud_aa.h: a glyph is a few parts (round-ended strokes, triangles, the
    top half of a ring) and aaFill paints their union per pixel, blended as the
    library's own smooth line blends. Turn arrows, the U-turn and the E60 lane
    arrows use it: smooth edges, no seam where parts overlap, round bends (the
    left/right corner had a notch, the sharp turn a hole, the U-turn gaps an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
2026-09-25 App: the speed limit without a route, and voice warnings with the app closed
    The owner: with no itinerary the limit often did not show (a route always
    fixed it), and after swiping the app away the HUD should keep the limit and,
    if possible, warn when over it.
    Why no limit without a route: a route's limits come from Mapbox, free
    drive's only from one public Overpass server. Busy, it backed off 30 s to
    10 minutes with nothing shown; slow, a road already on disk waited up to
    ~40 s for the network to fail first; and dropping the route (which swiping
    the app away does) threw away the road data it had.
    - A second Overpass server, overpass.private.coffee (Austrian non-profit,
    whole planet, no h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
    [AreaRoads.kt, HudService.kt, VoiceGuide.kt]
2026-09-25 App: the HUD compass learns its error from GPS, so hills and mounting stop mattering
    The owner: the board lies flat on the dashboard, so on a hill it is tilted
    with the car -- and it should not care which way it is mounted.
    At a ~65-degree dip every degree of tilt is ~2 degrees of heading, so a 10 %
    slope read 10-15 degrees out, and the arrow jumped by that whenever the car
    stopped and the compass took over from GPS. The board has no accelerometer
    and the head unit no sensors, and the magnetometer alone cannot see tilt
    (facing east or west it moves nothing but the heading).
    HeadingFusion.hudCorrection: the GPS course minus the board's reading,
    learned while driving on a straight at >= 9 km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
    [HeadingFusion.kt]
2026-09-25 App 1.34: the HUD compass stops caring about hills and how it is mounted
    Release of cfaada5 (CI green): versionCode 42, versionName 1.34, and the
    "## App 1.34" CHANGELOG section the release workflow uses as notes. It says
    plainly what a box turned more than 45 degrees does: the raw reading still
    feeds the distrust test, so after a stop the arrow keeps the GPS heading for
    a minute before the corrected compass takes over.
    CLAUDE.md "Where things are": HeadingFusion's hudCorrection, and where
    free-drive road data comes from (overpass-api.de, then
    overpass.private.coffee, AreaCache on disk) and VoiceGuide.warningsOnly.
    Claude-Session: htt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
2026-09-25 Docs: README's Tests section matches today's suites
    It still said nine firmware stages and 249 Android tests. Every number is
    now taken from a run in this session:
    - make check: 11 stages plus the end-to-end pass (screen geometry, the CAN
    simulator, the three sketch builds and PanelDiag were missing); the E60
    layout suite has 30 states. The stage labels "5-6." and "7-8." were not
    list markers, so GitHub merged them into the item above and renumbered
    the rest; it is now one list, 1-11, as make check prints them.
    - make render: 59 + 54 screens and what fails it (pinholes, a glyph without
    smooth edges or with a seam, a field painted over or left behind); CI runs
    it with make check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
